IHyperspaceI/Sandy/README.md

ATTiny works but needs redesign as ground pours are not connected. Hence, the IMU does not get power. The focus on small packaging led to certain compromises in layout, ultimately bringing the project's downfall.
Unfortunately, KiCAD was not configured to highlight isolated GNDs, and this oversight led to the issues.
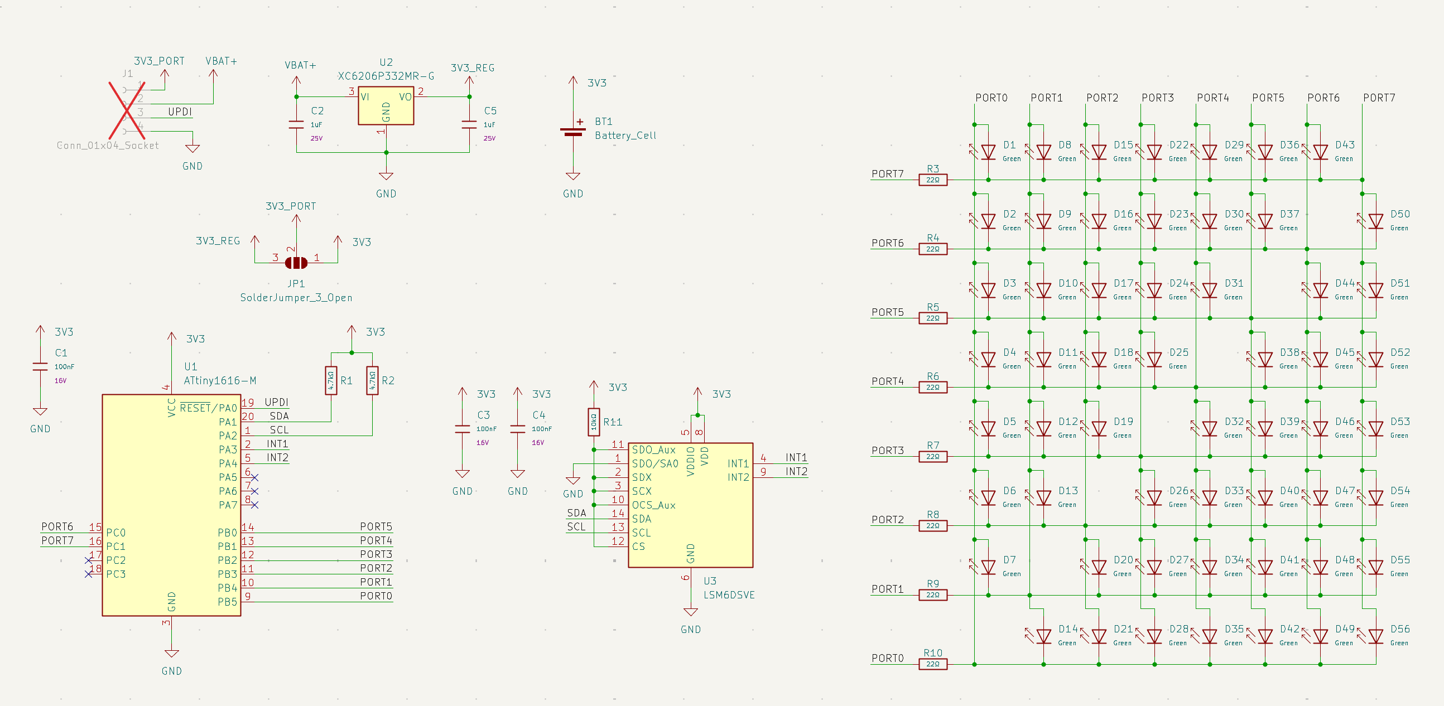
[picture p1: Photos/Schematic.png]


Top Layer:
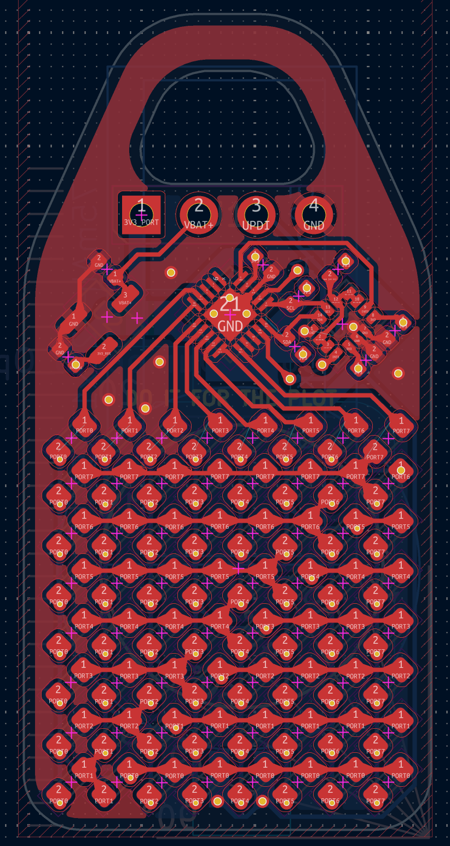
[picture p2: Photos/Top layer.png]


Bottom Layer
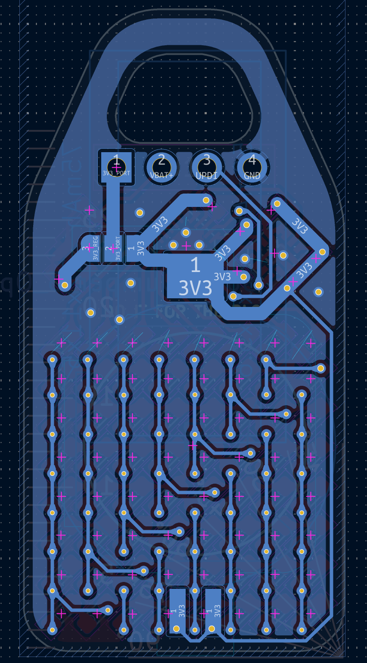
[picture p3: Photos/Bottom Layer.png]
