IHyperspaceI/Sandy/.step

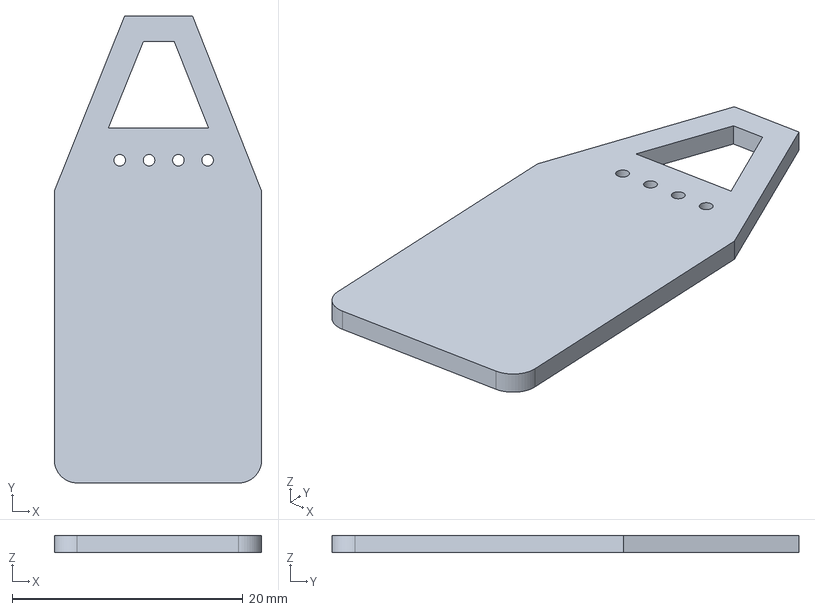
[picture p4: CAD file, 2026-05-14]
.step
18.0 x 40.5 x 1.51 mm
