IHyperspaceI/Sandy/Sandy.kicad_pcb

## KiCad design Sandy.kicad_pcb (2026-05-14)

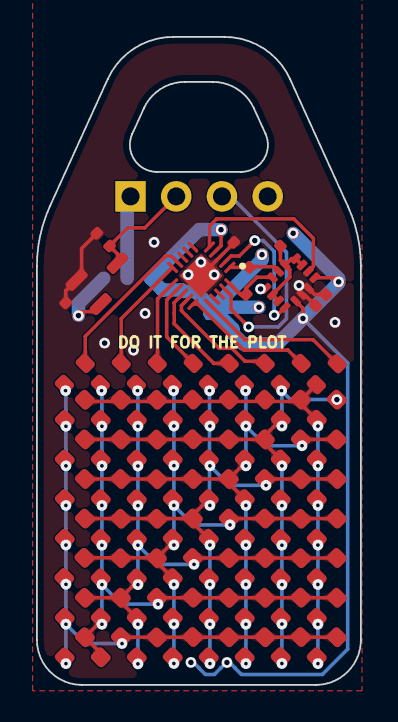
[picture p5: board Sandy.kicad_pcb from above]

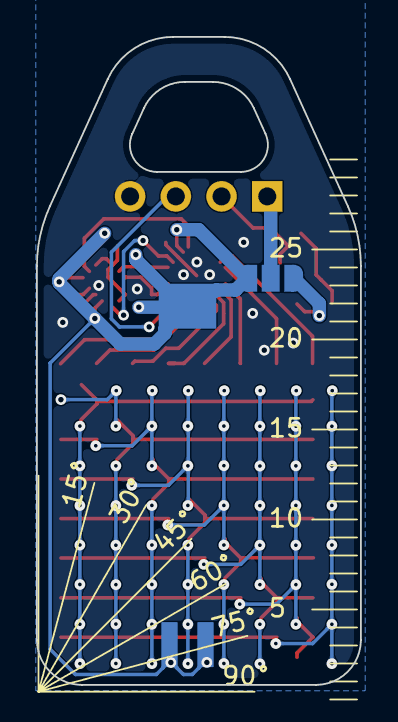
[picture p6: board Sandy.kicad_pcb from below]

Board: 2 copper layers, 18.0 x 36.0 mm, 78 parts (2 on the bottom side), 19 nets.

Parts:
BT1: Battery_Cell; BatteryHolder_Keystone_3092_Fucked_1.6x16mm
C1, C3, C4: 100nF; C_0402
C2, C5: 1uF; C_0402
D1, D2, D3, D4, D5, D6, D7, D8, D9, D10, D11, D12, D13, D14, D15, D16, D17, D18, D19, D20, D21, D22, D23, D24, D25, D26, D27, D28, D29, D30, D31, D32, D33, D34, D35, D36, D37, D38, D39, D40, D41, D42, D43, D44, D45, D46, D47, D48, D49, D50, D51, D52, D53, D54, D55, D56: Green; D_0603
J1: Conn_01x04_Socket; PinHeader_1x04_P2.54mm_Vertical
JP1: SolderJumper_3_Open; SolderJumper-3_P1.3mm_Open_RoundedPad1.0x1.5mm
R1, R2: 4.7kΩ; R_0402
R3, R4, R5, R6, R7, R8, R9, R10: 22Ω; R_0603
R11: 10kΩ; R_0402
U1: ATtiny1616-M; VQFN-20-1EP_3x3mm_P0.4mm_EP1.7x1.7mm
U2: XC6206P332MR-G; SOT-23-3
U3: LSM6DSVE; LGA-14_3x2.5mm_P0.5mm_LayoutBorder3x4y

Connections:
3V3: BT1.1 (+_1), C1.1, C3.1, C4.1, JP1.1 (A), R1.1, R2.1, R11.1, U1.4 (VCC), U3.5 (VDDIO), U3.8 (VDD)
3V3_PORT: J1.1, JP1.2 (C)
3V3_REG: C5.1, JP1.3 (B), U2.2 (VO)
/INT1: U1.2 (PA3), U3.4 (INT1)
/INT2: U1.5 (PA4), U3.9 (INT2)
/PORT0: D1.2, D2.2, D3.2, D4.2, D5.2, D6.2, D7.2, D14.1, D21.1, D28.1, D35.1, D42.1, D49.1, D56.1, R10.1, R10.2, U1.9 (PB5)
/PORT1: D7.1, D8.2, D9.2, D10.2, D11.2, D12.2, D13.2, D14.2, D20.1, D27.1, D34.1, D41.1, D48.1, D55.1, R9.1, R9.2, U1.10 (PB4)
/PORT2: D6.1, D13.1, D15.2, D16.2, D17.2, D18.2, D19.2, D20.2, D21.2, D26.1, D33.1, D40.1, D47.1, D54.1, R8.1, R8.2, U1.11 (PB3)
/PORT3: D5.1, D12.1, D19.1, D22.2, D23.2, D24.2, D25.2, D26.2, D27.2, D28.2, D32.1, D39.1, D46.1, D53.1, R7.1, R7.2, U1.12 (PB2)
/PORT4: D4.1, D11.1, D18.1, D25.1, D29.2, D30.2, D31.2, D32.2, D33.2, D34.2, D35.2, D38.1, D45.1, D52.1, R6.1, R6.2, U1.13 (PB1)
/PORT5: D3.1, D10.1, D17.1, D24.1, D31.1, D36.2, D37.2, D38.2, D39.2, D40.2, D41.2, D42.2, D44.1, D51.1, R5.1, R5.2, U1.14 (PB0)
/PORT6: D2.1, D9.1, D16.1, D23.1, D30.1, D37.1, D43.2, D44.2, D45.2, D46.2, D47.2, D48.2, D49.2, D50.1, R4.1, R4.2, U1.15 (PC0)
/PORT7: D1.1, D8.1, D15.1, D22.1, D29.1, D36.1, D43.1, D50.2, D51.2, D52.2, D53.2, D54.2, D55.2, D56.2, R3.1, R3.2, U1.16 (PC1)
/SCL: R2.2, U1.1 (PA2), U3.13 (SCL)
/SDA: R1.2, U1.20 (PA1), U3.14 (SDA)
/UPDI: J1.3, U1.19 (~RESET/PA0)
GND: C1.2, C2.2, C3.2, C4.2, C5.2, J1.4, U1.3 (GND), U1.21 (GND), U2.1 (GND), U3.1 (SDO/SA0), U3.6 (GND), U3.7 (GND)
unnamed: R11.2, U3.2 (SDX), U3.3 (SCX), U3.10 (OCS_Aux), U3.11 (SDO_Aux), U3.12 (CS)
VBAT+: C2.1, J1.2, U2.3 (VI)
